kliddle29/sensor-project/SYSTEM_CHARTER.md

# Don't Leave

## It sees

| Reading | What it reads |
|---|---|
| `cm` | nobody: 213.9, 214.8, 213.2 (empty table, Nov 2) · no echo prints 400 · leaning in: 10, 12, 14 |
| `breath` | nobody: 4–7 (idle noise) · a light breath: 19–23 · a hard breath: 30+ |

## It calls you

| Name | Rule | Hold |
|---|---|---|
| devoted | `breath` over 18 | 3 s |
| deserter | `cm` 50 to 150 | 2 s |
| nobody | `cm` over 150 | 5 s |

Between rules, it keeps the last name.

## It does

| Name | Action |
|---|---|
| devoted | blue LED steady, buzzer silent, the OLED prints DEVOTED |
| deserter | red LED flashes, a siren that speeds up, the OLED prints DESERTER |
| nobody | every light off, the screen blank but for one dot that blinks every 5 s: it waits |

## For them / To them

| Name | For them | To them |
|---|---|---|
| devoted | it goes calm and quiet the moment you give it your breath | it only counts breath, so someone with asthma or in a mask can never be devoted |
| deserter | it tells you, out loud, that it noticed you drifting | it calls stepping back to talk to a friend desertion, and sirens at you for it |
| nobody | it rests instead of shouting at an empty room | it can't tell someone who left from someone standing quietly just past 150 cm |

## The rest

- **It refuses:** to keep score of how long you stayed or how often you left. Nothing is saved or sent.
- **Set aside:** Bryson's Don't Leave Me: it sirened at an empty room, and devoted needed under 12 cm and breath at once.
- **Sits next to:** LAUREN (Lauren Lee McCarthy, 2017), and pushes back: LAUREN watched to serve the people in the house; this watches to make you serve it.
- **The tension:** to see the whole piece you have to step back, and stepping back makes you a deserter.
