kliddle29/sensor-project/(commit log)

2026-10-29 Read the Arduino at 9600 baud to match the sketch
    The sketch and bench/sense-serial.js both run the serial port at 9600 now.
    At 115200 on one side and 9600 on the other, the page connected but read
    nothing usable.
2026-10-29 Rename oled_demo sketch to sensor_prototype
    Arduino needs the folder and the .ino to share a name, so both move to
    bench/sensor_prototype/. The header credits the template's oled_demo.ino,
    and bench/README.md points to the new path.
2026-10-29 Add breath sensor, second OLED, three LEDs and stepped beeper
    The piece wants attention. Breathing on the capacitive moisture sensor (A0)
    or staying close keeps it calm; walking away steps it up:
    - blue LED: chill, silent
    - white LED: a slow low beep
    - red LED: a faster high beep
    - past 150 cm for 1 s: a siren that speeds up, capped at 60 s
    Coming back gives one chirp.
    Breath is measured against a baseline taken at startup. A second OLED on a
    software I2C bus (SDA D2, SCL D3) shows the breath number. A Wire timeout
    stops a loose wire on the first OLED from freezing the Nano, and startup
    prints checkpoints (boot, oled ok, screen 2 ok, ready). The serial line is
    now "cm 42.5 moisture 512 brea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
    [sensor_prototype.ino]
2026-10-29 Tune thresholds: breath 30, blue under 12 cm, red past 50 cm
    Breathing on the sensor measured above 30, and idle noise stayed at 4-7,
    so a breath now has to reach 30. Blue (silent) is under 12 cm, white is
    12-50 cm, red is past 50 cm. The siren line stays at 150 cm, the same as
    the browser's "present" signal.
    [sensor_prototype.ino]
2026-10-29 Only stay silent when the person is close and breathing
    Silence used to need breath OR closeness; now it needs both: under 12 cm
    and a breath of 30 or more in the last 5 s. Missing either one gives the
    white LED and a slow beep.
    [sensor_prototype.ino]
2026-10-29 Move the distance OLED to D11/D12 and the breath OLED to A1/A2
    The breath screen stayed black on D2/D3 and works on A1/A2. The distance
    screen moved off A4/A5 to D11/D12, so both are software I2C now and the
    Wire timeout (hardware bus only) is gone.
    Known cost: the distance screen redraws slowly over software I2C, so the
    whole loop drops from about 8 readings a second to about 1.
2026-10-29 Add a photo of the working Sensor Prototype build
    Both screens running (breath on the left, distance on the right), the
    blue/white/red LEDs, the HC-SR04 and the moisture sensor.
2026-10-30 Lower breath threshold from 30 to 25
    A breath of 30 was too hard to reach, so the piece kept beeping during real
    breathing. 25 still sits well above the idle noise of 4-7.
    [sensor_prototype.ino]
2026-11-01 fixes #4: check that OLED 2 answers before using it
    The breath screen lights on A1/A2, but setup printed "screen 2 ok" whether
    or not the screen was there, because U8x8 never checks for an answer. That
    is how it stayed black on D2/D3 with nothing in the Serial Monitor to say so.
    Setup now asks the screen for an I2C answer first. It prints "screen 2 ok"
    only when the screen answers at 0x3C, switches to 0x3D for screens set to
    that address, and otherwise prints which wires to check.
    [sensor_prototype.ino]
2026-11-02 Fix HC-SR04 spelling, set bench.ino to 9600, ignore .DS_Store
    The README credits said HC-WR04. bench.ino still opened the port at 115200
    while the page reads at 9600. .gitignore keeps the Mac's .DS_Store out of
    the repo.
    [bench.ino]
2026-11-04 Move to one OLED on A4/A5 with distance and breath together
    Refs #7. Two software-I2C screens slowed the Nano to about 1 reading a
    second, so the breath screen is gone and the one OLED goes back on the
    hardware I2C pins (SDA A4, SCL A5), with the Wire timeout restored. The
    screen shows the level, the distance, the breath number against the 25
    threshold, and the raw moisture reading. The sonar sweep, the history
    graph and the second screen's address check are removed.
    Compiles for the Nano. Not uploaded or tested on the board yet.
2026-11-05 Finish the charter lines and start the README State Table
    SYSTEM_CHARTER.md gets For them and To them for every name, then It
    refuses, Set aside, Sits next to and The tension. README.md gets a State
    Table with the assignment's columns and the shared nobody row. Its three
    readings are blank until they are read off the Serial Monitor today.
2026-11-05 Fill the nobody readings with the Nov 2 empty-table readings
    213.9, 214.8 and 213.2 cm, recorded Nov 2 before the ultrasonic was
    rewired, and dated as such in the row. They are not today's readings.
2026-11-05 Add the devoted row to the State Table
    devoted sits above nobody: breath over 25 (LINE 25, GAP 3) held 3 s, shown
    by the word DEVOTED on the OLED and the blue LED on D5. The three readings
    at the edge are blank until they are read off the Serial Monitor.
    Refs #12, #13, #14.
2026-11-06 State Table: add the deserter row
    Every column but the readings is filled from the charter. The three
    readings at the 50 cm edge still have to be taken off the Serial Monitor.
2026-11-06 Add design.jpg: the form, the visitor, the name, every wire, parts
    One sheet for Draw It, part 3. The wiring follows the one-OLED sketch on
    bryson/one-oled, which isn't on main yet.
2026-11-06 State Table: fill the deserter readings at the 50 cm edge
    49, 48 and 46 cm off the Serial Monitor. They wobble by 3 cm, so GAP 5 holds.
2026-11-06 Ignore missed echoes and wild readings in the distance
    Refs #7, #10. A ping with no echo used to count as 400 cm and drag the
    OLED number around. Now a miss keeps the last distance until five misses
    in a row, a median of the last three real readings drops single spikes,
    and each ping waits for ECHO to go low first. The serial line prints cm
    (cleaned up) and ping (raw, 0 = no echo).
    Tested on the board Nov 4: 191 of 191 pings echoed with a hand at 4-17 cm
    after the ultrasonic was rewired. Far range not tested; pointed at nothing
    it reads a steady 5.6 cm, which looks like something in front of the
    sensor rather than the filter.
    [sensor_prototype.ino]
2026-11-06 Name people devoted, deserter or nobody, as the charter says
    Refs #12, #13, #14. The old CHILL/FADING/WARN/ALARM levels are replaced by
    the three names from SYSTEM_CHARTER.md and the README State Table:
    - devoted: breath over 25 for 3 s. Blue LED steady, silent, OLED DEVOTED.
    - deserter: cm 50 to 150 for 2 s. Red LED flashes, a siren that speeds up
    (gives up after 60 s), OLED DESERTER.
    - nobody: cm over 150 for 5 s. Everything off; the screen is blank but for a
    dot that blinks every 5 s.
    Rows are checked top to bottom and the first one true for its whole hold
    wins. The current name gets its GAP (3 breath, 5 cm, 10 cm) so a reading on
    the line doesn't flicker. No true row keeps the last n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
    [sensor_prototype.ino]
2026-11-06 Add design-wiring.jpg: the hand-drawn wiring schematic
    Bryson and Kenzo's pencil drawing of every wire and its Nano pin, next to
    design.jpg. One mistake on the sheet: the buzzer's + and - are swapped.
    The real wiring is + to D4 and - to GND.
2026-11-06 Bring back the one-OLED screen and lower the breath line to 18
    Puts bench/sensor_prototype/sensor_prototype.ino back to how it was after
    PR 23 (e0236e7): the level badge, the distance and the breath line on one
    screen, with blue, white and red stepping up to the siren. The
    devoted/deserter/nobody version from PR 24 left the screen blank most of
    the time, so we're going back to the screen we tested. It's still on the
    bryson/charter-names branch history if we want it later.
    The breath line drops from 25 to 18 in the sketch, the charter's devoted
    rule, and the State Table's LINE, because 25 was too hard to reach.
    Uploaded to the Nano Nov 6: runs at about 6.4 readings a second and reads
    about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
2026-11-06 Show the charter's names on the screen and let nobody rest
    Refs #12. The badge now reads DEVOTED, DESERTER or NOBODY instead of CHILL,
    FADING, WARN or ALARM, and the screen still shows the distance and breath
    under it. To match the charter:
    - NOBODY (past 150 cm, now held 5 s instead of 1 s) is quiet: LEDs off,
    no siren. Someone arriving gets one chirp.
    - The siren moves to the red level (50-150 cm, DESERTER), so the red LED
    flashes and the siren speeds up there, giving up after 60 s.
    - DEVOTED (close and breath over 18) stays blue and silent; white still
    beeps slowly and is labelled DESERTER.
    Uploaded to the Nano Nov 6: runs at about 6 readings a second. Not yet
    checked by eye that e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
2026-11-10 docs: flash sensor_prototype.ino and read the port at 9600
    Fixes #29. The bench steps still said to flash bench.ino and open the
    Serial Monitor at 115200. Our sketch is bench/sensor_prototype, it talks
    at 9600, and our Nano only uploads with the Old Bootloader setting.
2026-11-10 Add bench/DIAGNOSTICS.md with the Nov 10 readings
    Refs #30. Records how to run a hands-off check and what the Nano read on
    Nov 10: 6.9 readings a second, 0 of 284 echoes missed, ping 8.4 cm
    (+/-0.3) from something on the desk, moisture 481-487, breath -1 to 0.
2026-11-10 Print the current name on every serial line
    Refs #13, #16. Each line now ends with "name devoted", "name deserter" or
    "name nobody", matching the badge, so the holds those issues ask for can be
    checked on the Serial Monitor. sense-serial.js skips words it can't read
    as numbers, so the browser is unaffected.
    Uploaded to the Nano Nov 10: 7 readings a second, and the name shows on
    every line.
    [sensor_prototype.ino]
2026-11-10 Stop calling an empty desk devoted for 5 s after startup
    setup() set lastBreath to the start time to give a grace period, so for
    the first 5 s anything under 12 cm counted as close and breathing, and the
    badge said DEVOTED with breath at 0. Now a breath only counts once a real
    one has crossed the line (breathedYet), and the serial line is printed
    after updateLevel, so even the first line names the right level.
    Checked on the Nano Nov 10 with something 7 cm in front and no breath:
    before, 5 s of "devoted" after reset; after, 113 of 113 lines say
    "deserter" from the first one.
    [sensor_prototype.ino]
2026-11-10 Screen experiment 1/10: center the distance number
    A layout experiment to compare on the real OLED. Only the drawing code
    changes; the sensors, names, LEDs and buzzer are untouched. Uploaded to the
    Nano and checked: 6.9 readings a second on the Serial Monitor.
    [sensor_prototype.ino]
2026-11-10 Screen experiment 2/10: badge on the right, readings per second on the left
    Nano and checked: 7.0 readings a second on the Serial Monitor.
    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
    [sensor_prototype.ino]
2026-11-10 Screen experiment 3/10: bold badge font
    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
    [sensor_prototype.ino]
2026-11-10 Screen experiment 4/10: breath as a bar instead of a number
    Nano and checked: 7.4 readings a second on the Serial Monitor.
    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
    [sensor_prototype.ino]
2026-11-10 Screen experiment 5/10: distance bar along the bottom instead of the raw reading
    Nano and checked: 7.7 readings a second on the Serial Monitor.
    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
    [sensor_prototype.ino]
2026-11-10 Screen experiment 6/10: distance in metres
    Nano and checked: 6.2 readings a second on the Serial Monitor.
    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
    [sensor_prototype.ino]
2026-11-10 Screen experiment 7/10: a border around the whole screen
    Nano and checked: 5.4 readings a second on the Serial Monitor.
    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
    [sensor_prototype.ino]
2026-11-10 Screen experiment 8/10: hide the readings-per-second counter
    Nano and checked: 5.5 readings a second on the Serial Monitor.
    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
    [sensor_prototype.ino]
2026-11-10 Screen experiment 9/10: smaller distance number
    Nano and checked: 6.8 readings a second on the Serial Monitor.
    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
    [sensor_prototype.ino]
2026-11-10 Screen experiment 10/10: solid header bar across the top
    Nano and checked: 6.3 readings a second on the Serial Monitor.
    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
    [sensor_prototype.ino]
2026-11-10 README: add our build and its wiring table
    Every part, pin and Nano connection in one table, matching the sketch and
    the schematic, plus the two things that bit us: the breath probe needs 5V,
    and RX0/TX1/RST must stay empty for uploads.
2026-11-10 README: troubleshooting from the problems we hit
    Nine symptoms from the break log and our issues, each with the cause and
    the fix: uploads, baud rate, a frozen OLED, the probe on 3.3 V, stuck or
    missing distance readings, the white LED and an unreachable breath line.
2026-11-10 README: show the build photo and both drawings
    The build photo and design.jpg / design-wiring.jpg were already in the
    repo but not on the README; now they sit side by side above the wiring
    table.
2026-11-10 Hold 50-150 cm for 2 s before the siren
    Fixes #16. The siren level (red LED, siren, DESERTER) started the moment
    the smoothed distance crossed 50 cm, so walking past set it off. Now each
    level the piece wants is a candidate that has to hold: 2 s for the siren
    level and 5 s for nobody, as the charter says. Until then it keeps the name
    it has. This replaces the old farSince timer, which only covered nobody.
    Compiles for the Nano. Not yet walked through with a person.
    [sensor_prototype.ino]
2026-11-10 Breath has to stay over 18 for 3 s to count
    Fixes #13. A single reading over the line used to count as a breath. Now
    breath must stay over 18 for 3 s (the charter's hold) before it counts, so
    a short puff doesn't make you devoted. Once it's over, it may dip by the
    State Table's GAP of 3 between breaths without resetting the 3 s. A counted
    breath still lasts 5 s.
    Compiles for the Nano. Not uploaded: the Nano was unplugged.
    [sensor_prototype.ino]
2026-11-10 bench.html: name people devoted, deserter or nobody like the Nano
    Refs #31. The browser's table still had the template's close / here /
    nobody. sense-serial.js gains a breath signal from the sketch's "breath"
    number (0.5 = the Nano's line of 18), and table-bench.js uses the charter's
    names and holds: devoted (under about 12 cm and breath over the line, 3 s),
    deserter (anyone within 150 cm, 2 s), nobody (5 s).
    Checked the rows in node. Not yet opened in bench.html with the Nano
    plugged in, so #31 stays open for that.
